DeeQay/KEDRA-KILIC-Diplomarbeit/docs/Diplomarbeit_Praesentation.pdf

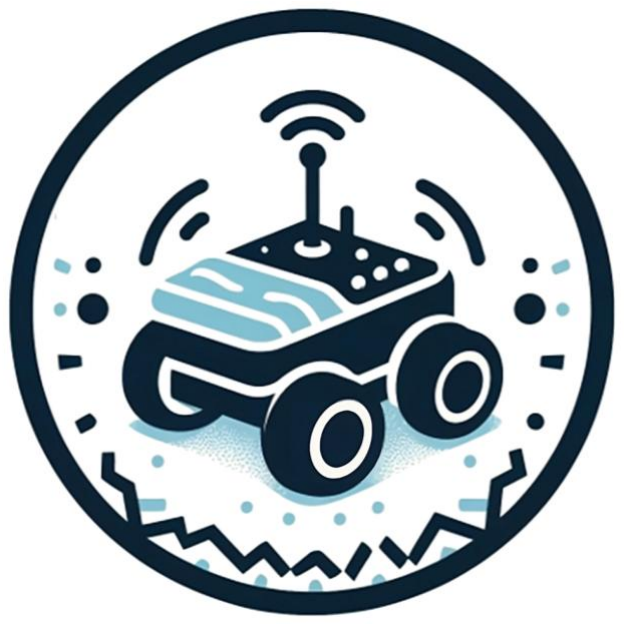
[picture p55: figure]

# Ferngesteuertes Fahrzeug mit Positionserkennung

Übungsteilnehmer: David KEDRA (verantwortlich), Berdan KILIC

2023/2024 5AHEL

Hauptbetreuer: Ahmet KILIC

Zusatzbetreuer: Heinrich HAAGER | 1 von 14

## David Kedra

Vorstellung

## - Ferngesteuertes Fahrzeug über Bluetooth - Umgebungserkennung und -speicherung - Bildschirm für Umgebung und Menü - Optimale Routenfindung zum markierten Punkt

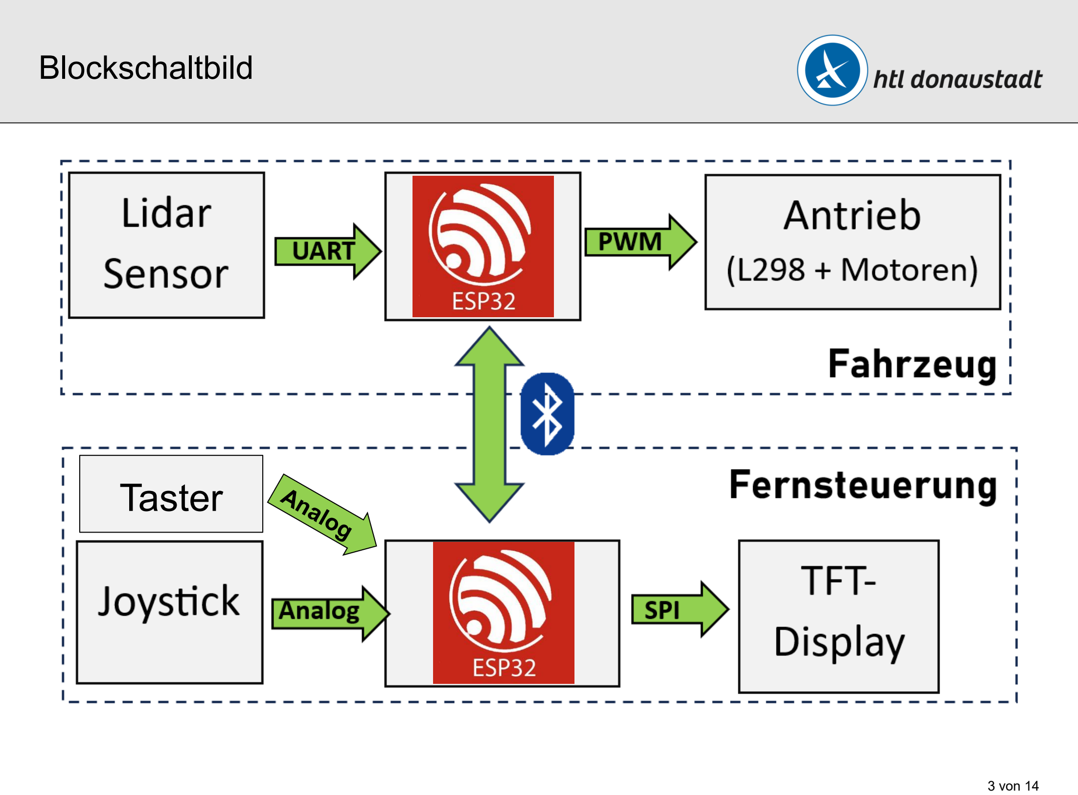
[picture p56: page 3]

Blockschaltbild

Taster

Aufgabenbereich der einzelnen Teilnehmer

## Berdan KILIC:

- Fahrzeugsteuerung

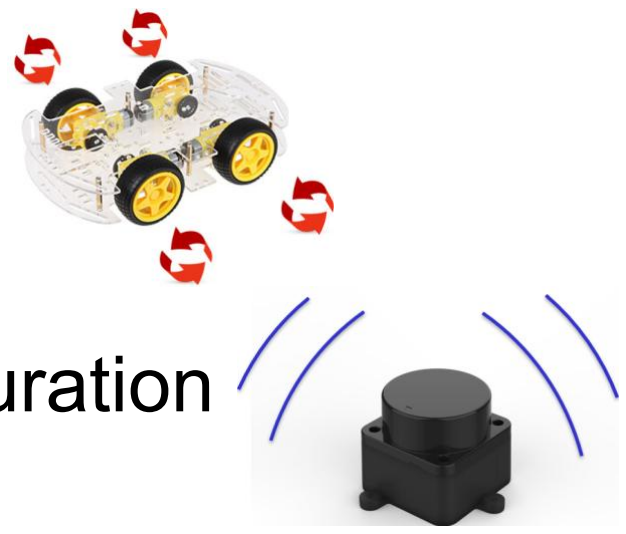
[picture p57: figure]

- 360° Sensor Konfiguration

## David KEDRA:

- Kommunikation der beiden Projektkomponenten

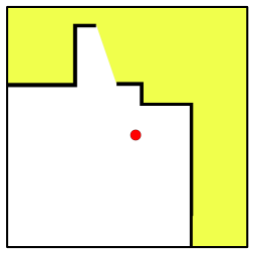
[picture p58: figure]

- Visualisierung am Bildschirm
- Umgebungsspeicherung

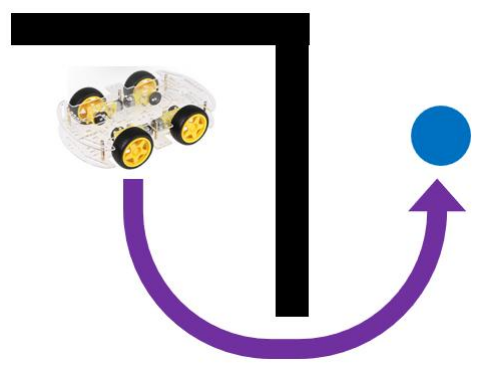
[picture p59: figure]

- Positionsrückfindung

Bluetooth - Kommunikation

## - Brücke zwischen Controller und Fahrzeug

## - drahtlose Datenübertragung

## - Bluetooth-Protokoll regelt Datenaustausch

Lidar

Joystick

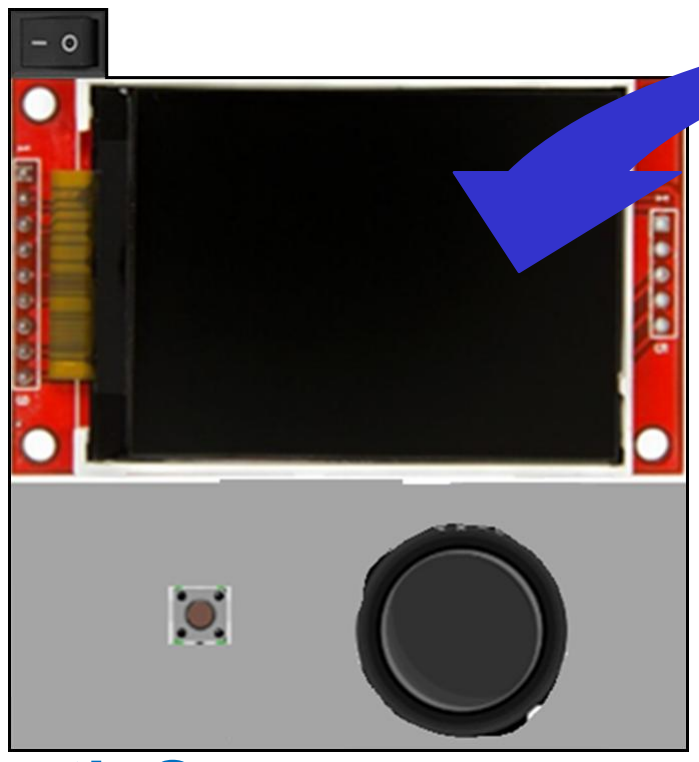
[picture p60: figure]
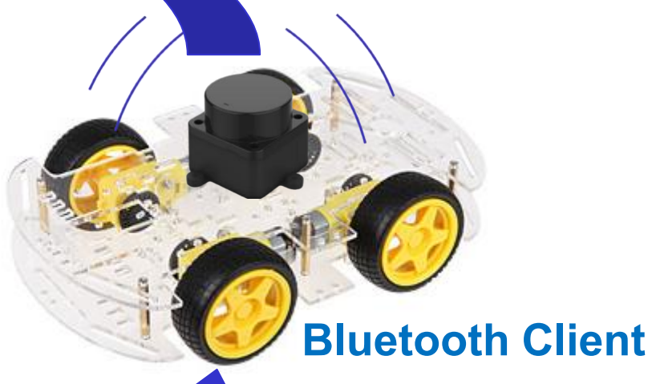
[picture p61: figure]
Bluetooth Client

Bluetooth Server

Bluetooth Datenformatierung

- Erste Information: Nachrichtentyp-Nummer
- Rest: übermittelte Daten

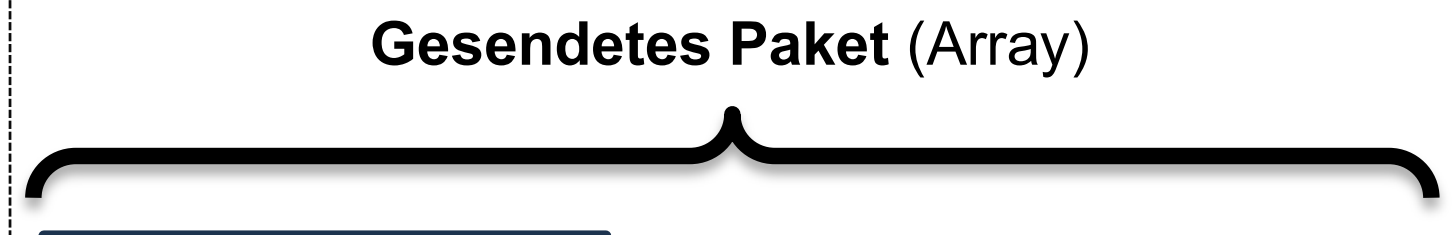
[picture p62: figure]
Gesendetes Paket (Array)
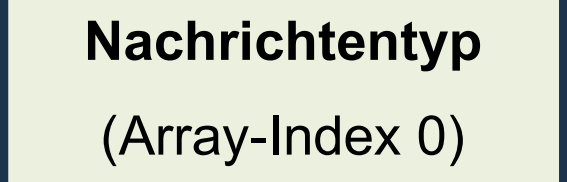
[picture p63: figure]
(Array-Index 0)

- Nachrichtentypen:
0 → Joystick
1 → Lidar
- Befehlszeichen:

\n → Nächster Wert einer Nachricht

\0 → Ende einer Nachricht Nachrichtentyp

Bluetooth Identifizierung der Formatierung

Joystick

Was gesendet wird: 0, \n, 5, 7, \n, 1, 4, 3, \0

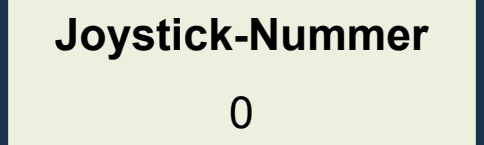
[picture p64: figure]
Joystick-Nummer
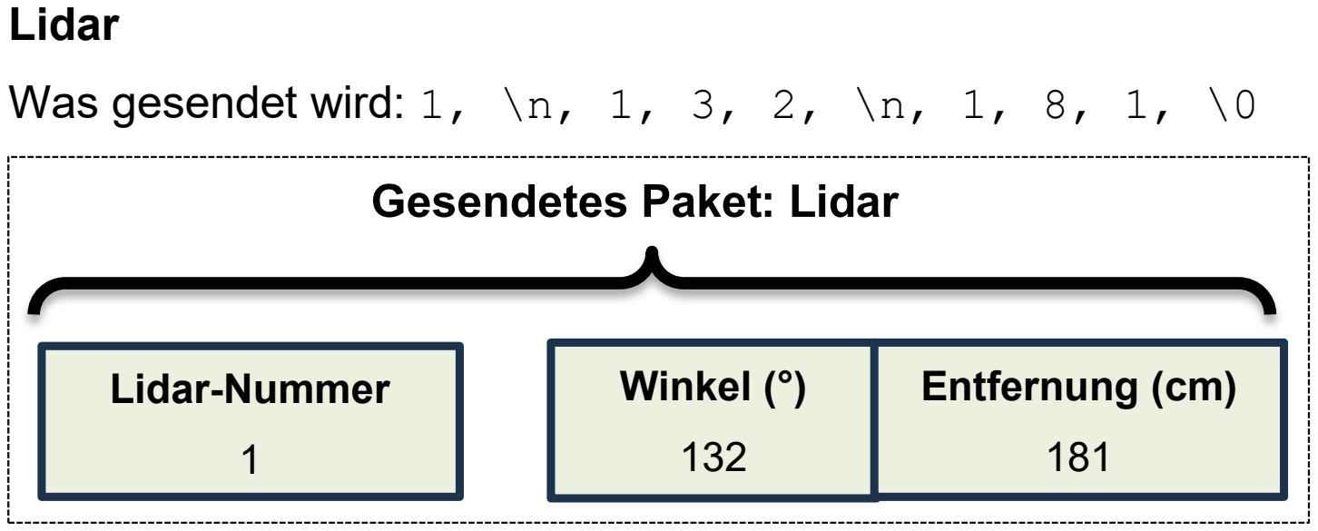
[picture p65: figure]
Lidar; Lidar-Nummer; Winkel (°); Gesendetes Paket: Lidar; Entfernung (cm)

Was gesendet wird: 1, \n, 1, 3, 2, \n, 1, 8, 1, \0

TFT-Display

## - TFT LCD Modul

## - 3,5 Zoll

## - 480x320 Pixel

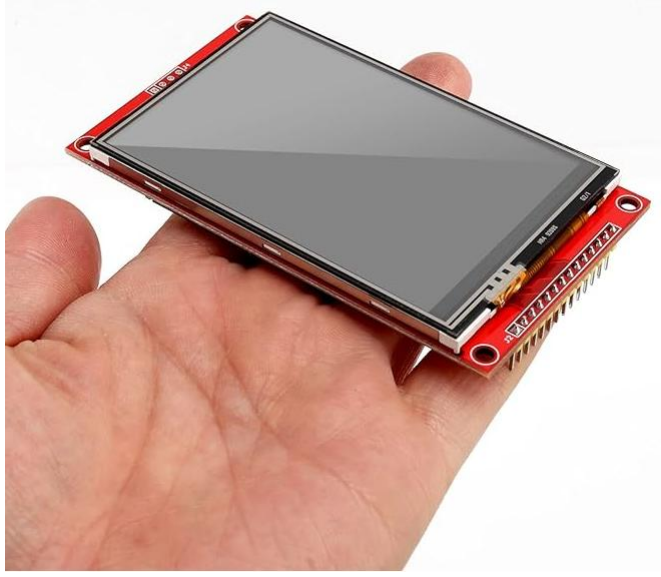
[picture p66: figure]

## - 4-Draht-SPI-Schnittstelle

## - ILI9488 Treiber

## - Information von 360° Sensor verarbeitet

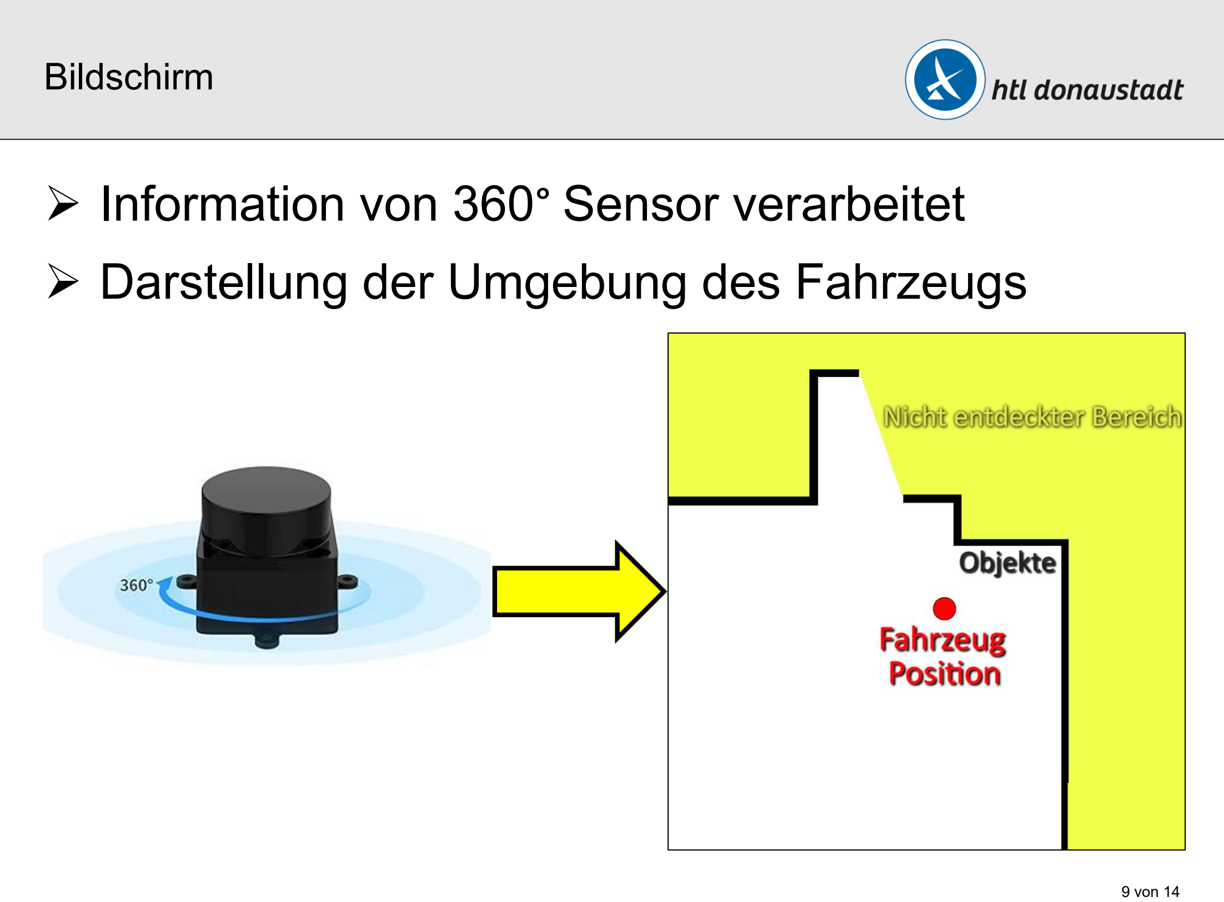
[picture p67: page 9]

Bildschirm

## - Darstellung der Umgebung des Fahrzeugs

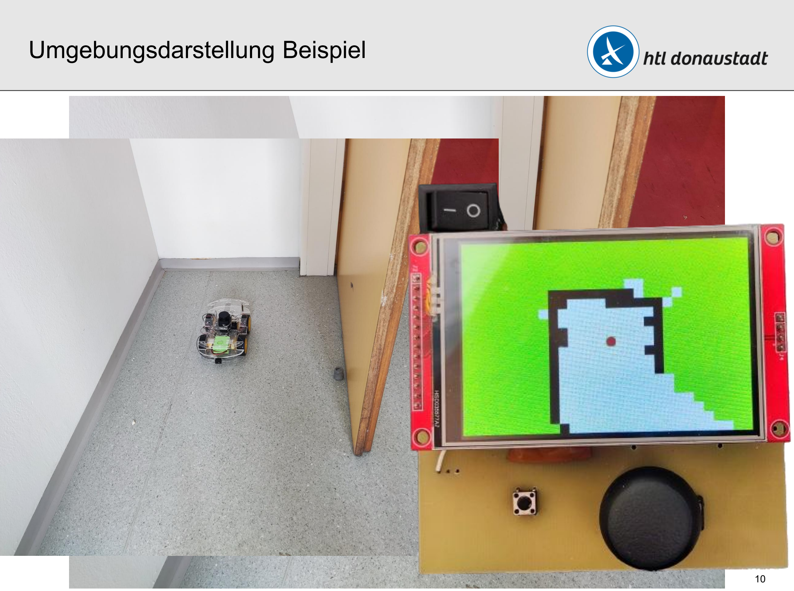
[picture p68: page 10]

Umgebungsdarstellung Beispiel

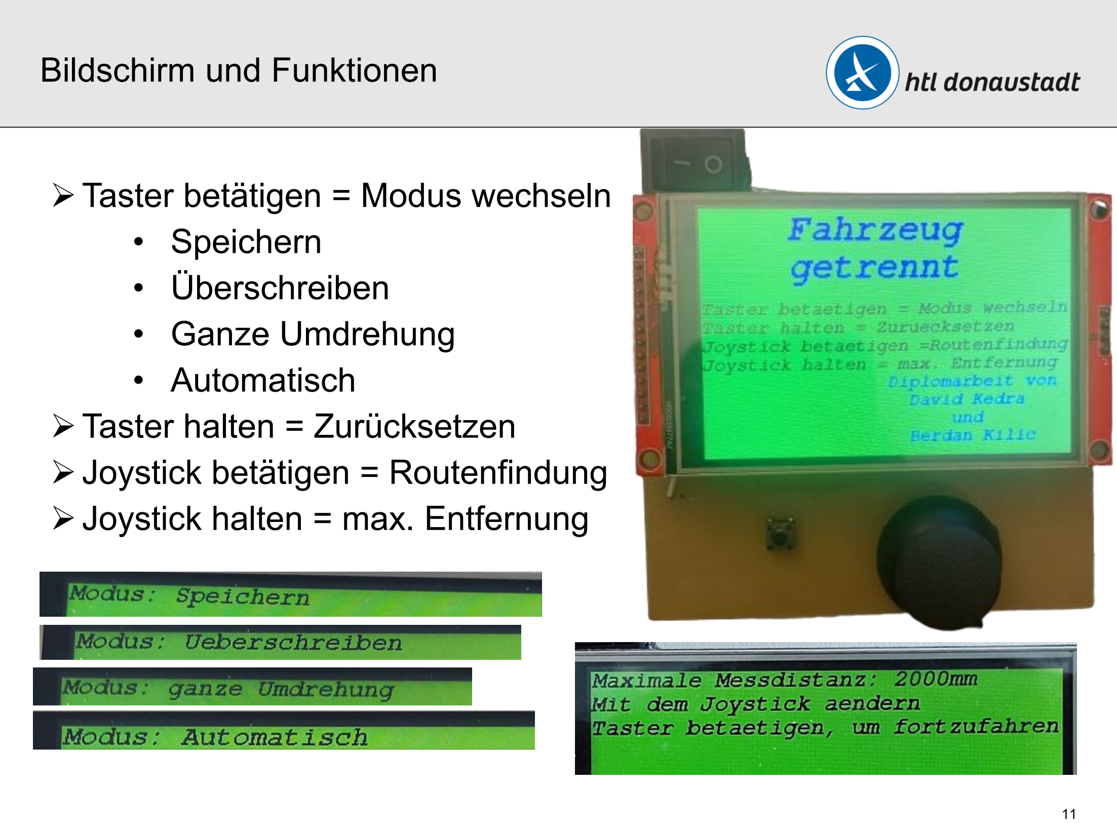
[picture p69: page 11]

Bildschirm und Funktionen

➢Taster betätigen = Modus wechseln
- Speichern
- Überschreiben
- Ganze Umdrehung
- Automatisch
➢Taster halten = Zurücksetzen ➢Joystick betätigen = Routenfindung ➢Joystick halten = max. Entfernung

Speichern und Überschreiben

1. Unbekannt zwischen Objekt und Anzeigeende (nur Überschreiben)
2. Luft zwischen Objekt und Lidar-Sensor aktualisieren

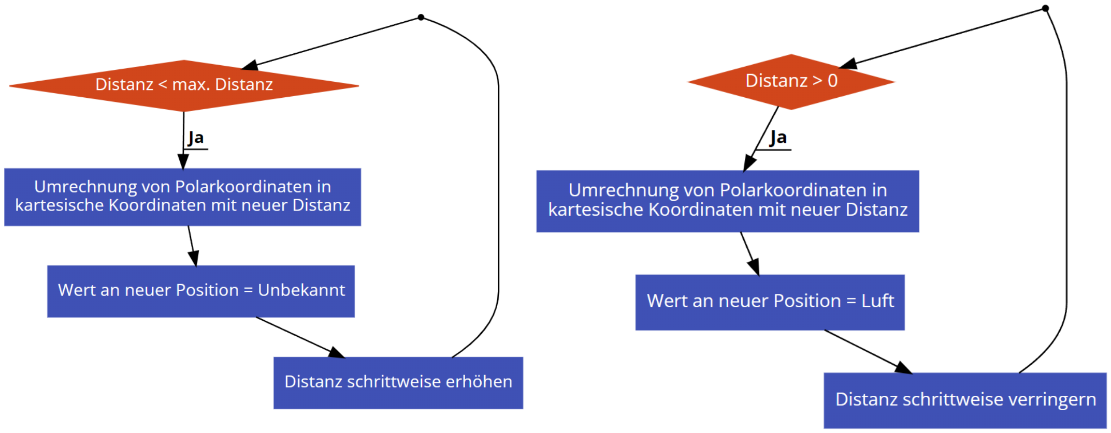
[picture p70: figure]
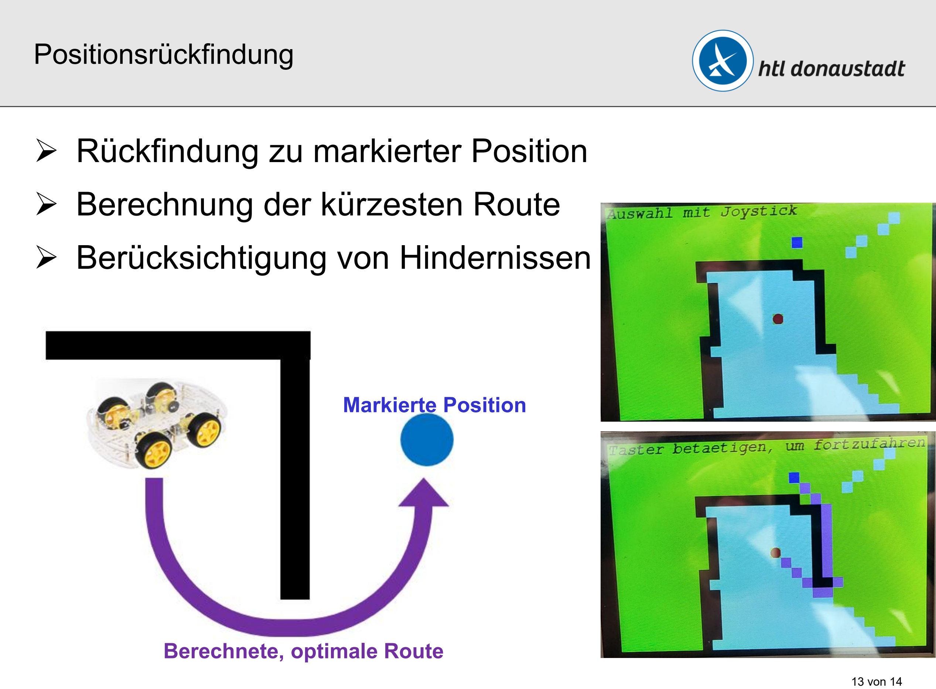
[picture p71: page 13]

Positionsrückfindung

- Rückfindung zu markierter Position
- Berechnung der kürzesten Route
- Berücksichtigung von Hindernissen

Berechnete, optimale Route

Markierte Position

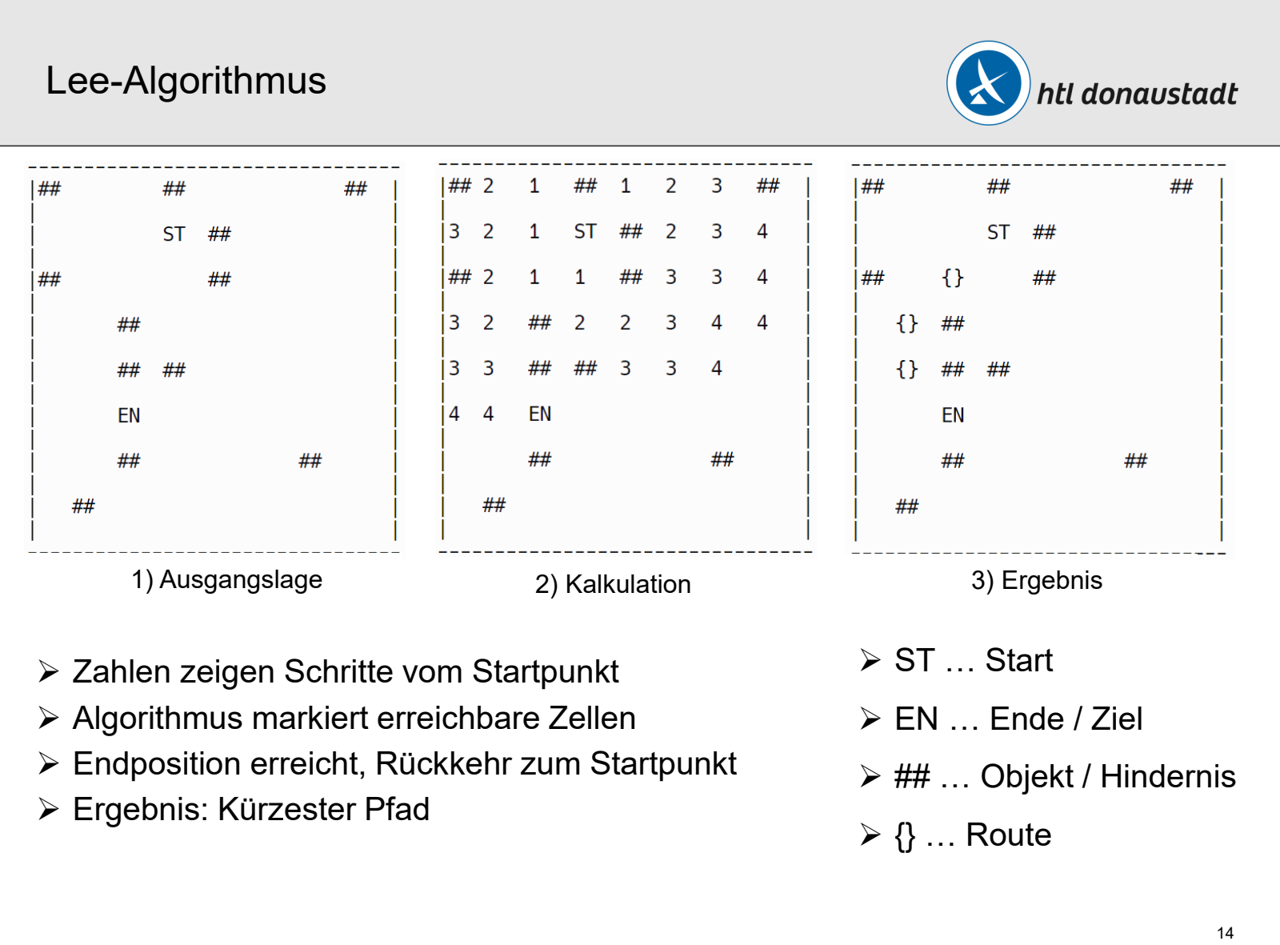
[picture p72: page 14]

Lee-Algorithmus

1) Ausgangslage | 2) Kalkulation | 3) Ergebnis
- ST … Start
- EN … Ende / Ziel
- ## … Objekt / Hindernis
- {} … Route
- Zahlen zeigen Schritte vom Startpunkt
- Algorithmus markiert erreichbare Zellen
- Endposition erreicht, Rückkehr zum Startpunkt
- Ergebnis: Kürzester Pfad

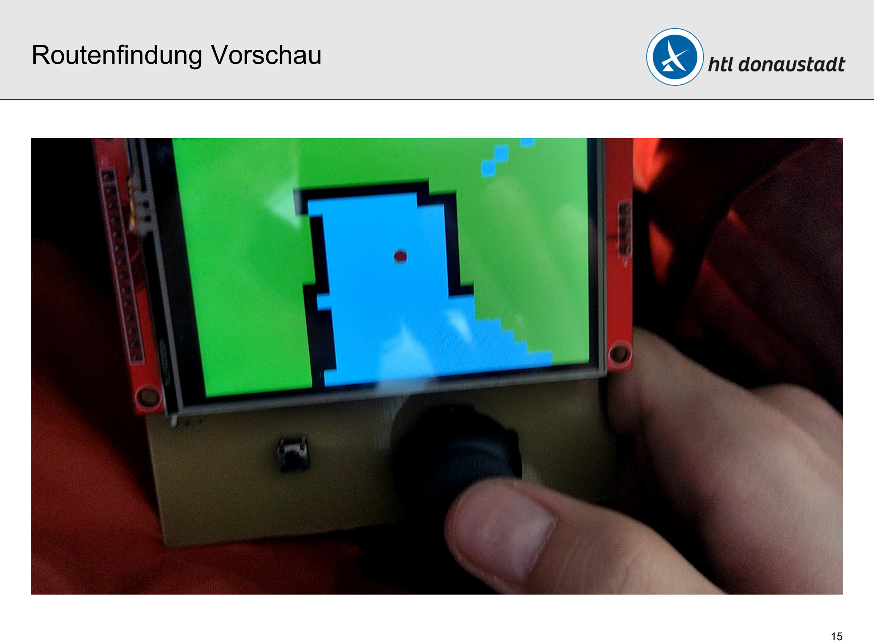
[picture p73: page 15]

Routenfindung Vorschau

Stromlaufplan

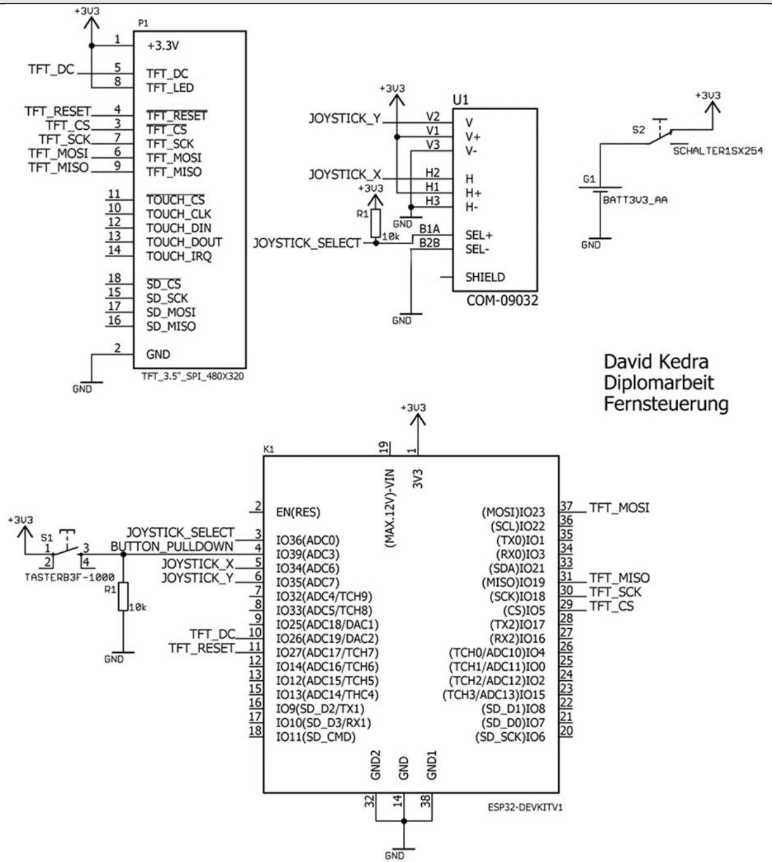
[picture p74: figure]
