DeeQay/KEDRA-KILIC-Diplomarbeit/docs/Projektvorstellung_2023-10.pdf

05.10.2023

## Ferngesteuertes Fahrzeug mit

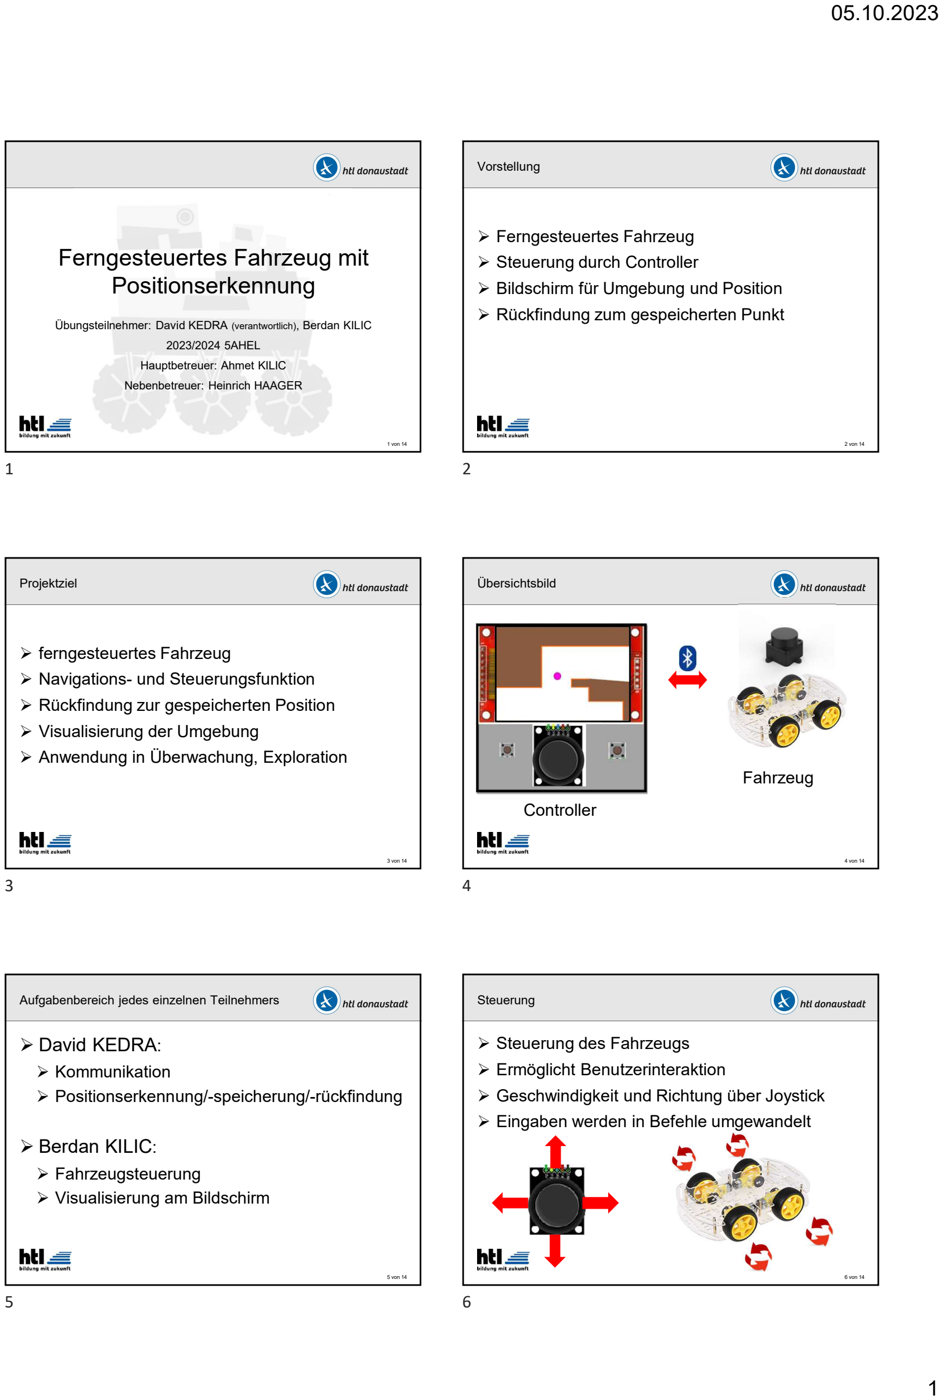
[picture p75: page 1]

1

## Positionserkennung

Übungsteilnehmer: David KEDRA (verantwortlich), Berdan KILIC 2023/2024 5AHEL
Hauptbetreuer: Ahmet KILIC Nebenbetreuer: Heinrich HAAGER

### 1 von 14

Vorstellung

- Ferngesteuertes Fahrzeug
- Steuerung durch Controller
- Bildschirm für Umgebung und Position
- Rückfindung zum gespeicherten Punkt | 2 von 14 Projektziel
- ferngesteuertes Fahrzeug
- Navigations- und Steuerungsfunktion
- Rückfindung zur gespeicherten Position
- Visualisierung der Umgebung
- Anwendung in Überwachung, Exploration

### 3 von 14

Übersichtsbild

Fahrzeug

Controller | 4 von 14 Aufgabenbereich jedes einzelnen Teilnehmers
- David KEDRA:
- Kommunikation
- Positionserkennung/-speicherung/-rückfindung
- Berdan KILIC:
- Fahrzeugsteuerung
- Visualisierung am Bildschirm

### 5 von 14

Steuerung

- Steuerung des Fahrzeugs
- Ermöglicht Benutzerinteraktion
- Geschwindigkeit und Richtung über Joystick
- Eingaben werden in Befehle umgewandelt 6 von 14

1 2

3 4

5 6

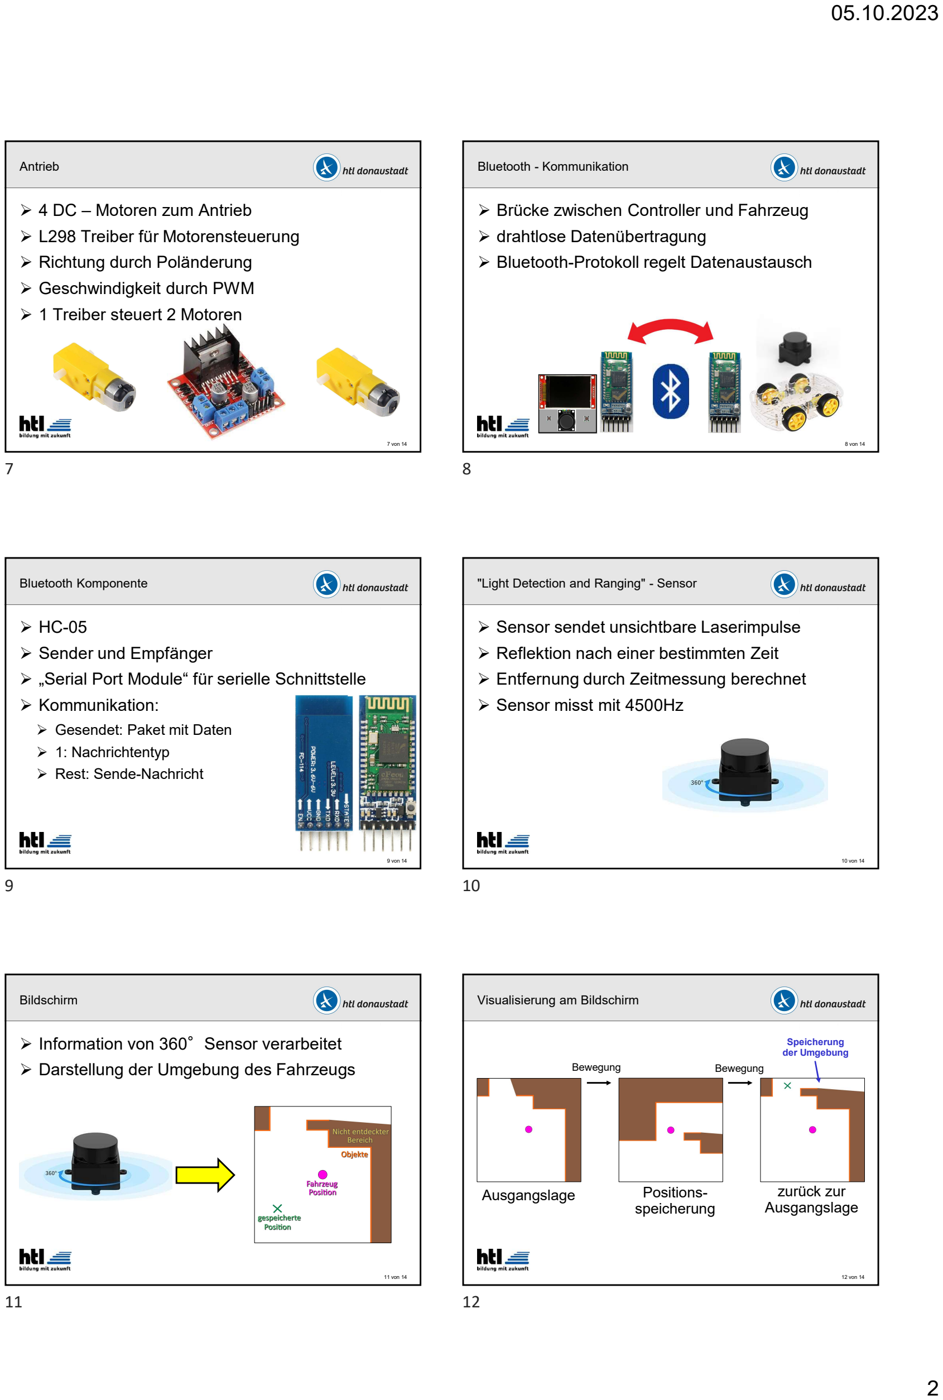
[picture p76: page 2]

2

Antrieb

- 4 DC – Motoren zum Antrieb
- L298 Treiber für Motorensteuerung
- Richtung durch Poländerung
- Geschwindigkeit durch PWM
- 1 Treiber steuert 2 Motoren

### 7 von 14

Bluetooth - Kommunikation

- Brücke zwischen Controller und Fahrzeug
- drahtlose Datenübertragung
- Bluetooth-Protokoll regelt Datenaustausch

### 8 von 14 Bluetooth Komponente

- HC-05
- Sender und Empfänger
- „Serial Port Module“ für serielle Schnittstelle
- Kommunikation:
- Gesendet: Paket mit Daten
- 1: Nachrichtentyp
- Rest: Sende-Nachricht | 9 von 14

"Light Detection and Ranging" - Sensor

- Sensor sendet unsichtbare Laserimpulse
- Reflektion nach einer bestimmten Zeit
- Entfernung durch Zeitmessung berechnet
- Sensor misst mit 4500Hz | 10 von 14 Bildschirm
- Information von 360°Sensor verarbeitet
- Darstellung der Umgebung des Fahrzeugs 11 von 14

Visualisierung am Bildschirm

Positionsspeicherung Ausgangslage

Bewegung | Bewegung

zurück zur
Ausgangslage

Speicherung
der Umgebung

### 12 von 14

7 8

9 10

11 12

3

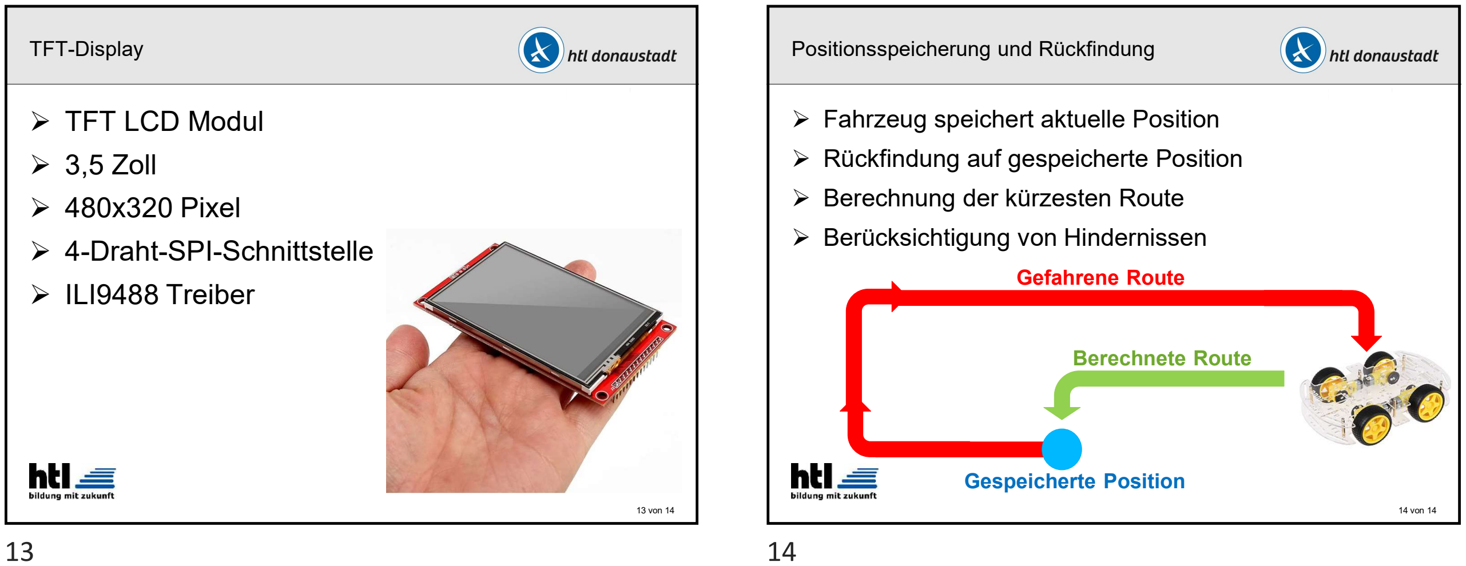
[picture p77: figure]
TFT-Display; TFT LCD Modul 3,5 Zoll 480x320 Pixel 4-Draht-SPI-Schnittstelle; ILI9488 Treiber; 13 von 14; Positionsspeicherung und Rückfindung; Fahrzeug speichert aktuelle Position Rückfindung auf gespeicherte Position Berechnung der kürzesten Route Berücksichtigung von Hindernissen; Gefahrene Route; Gespeicherte Position; Berechnete Route; 14 von 14
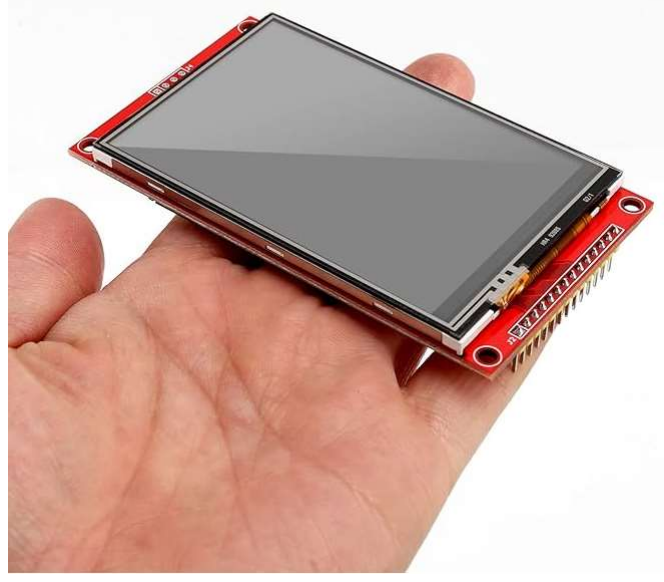
[picture p78: figure]
