DeeQay/KEDRA-KILIC-Diplomarbeit/Platinen/Fahrzeug/Fahrzeug.brd

## EAGLE design Platinen/Fahrzeug/Fahrzeug.brd (2024-04-22)

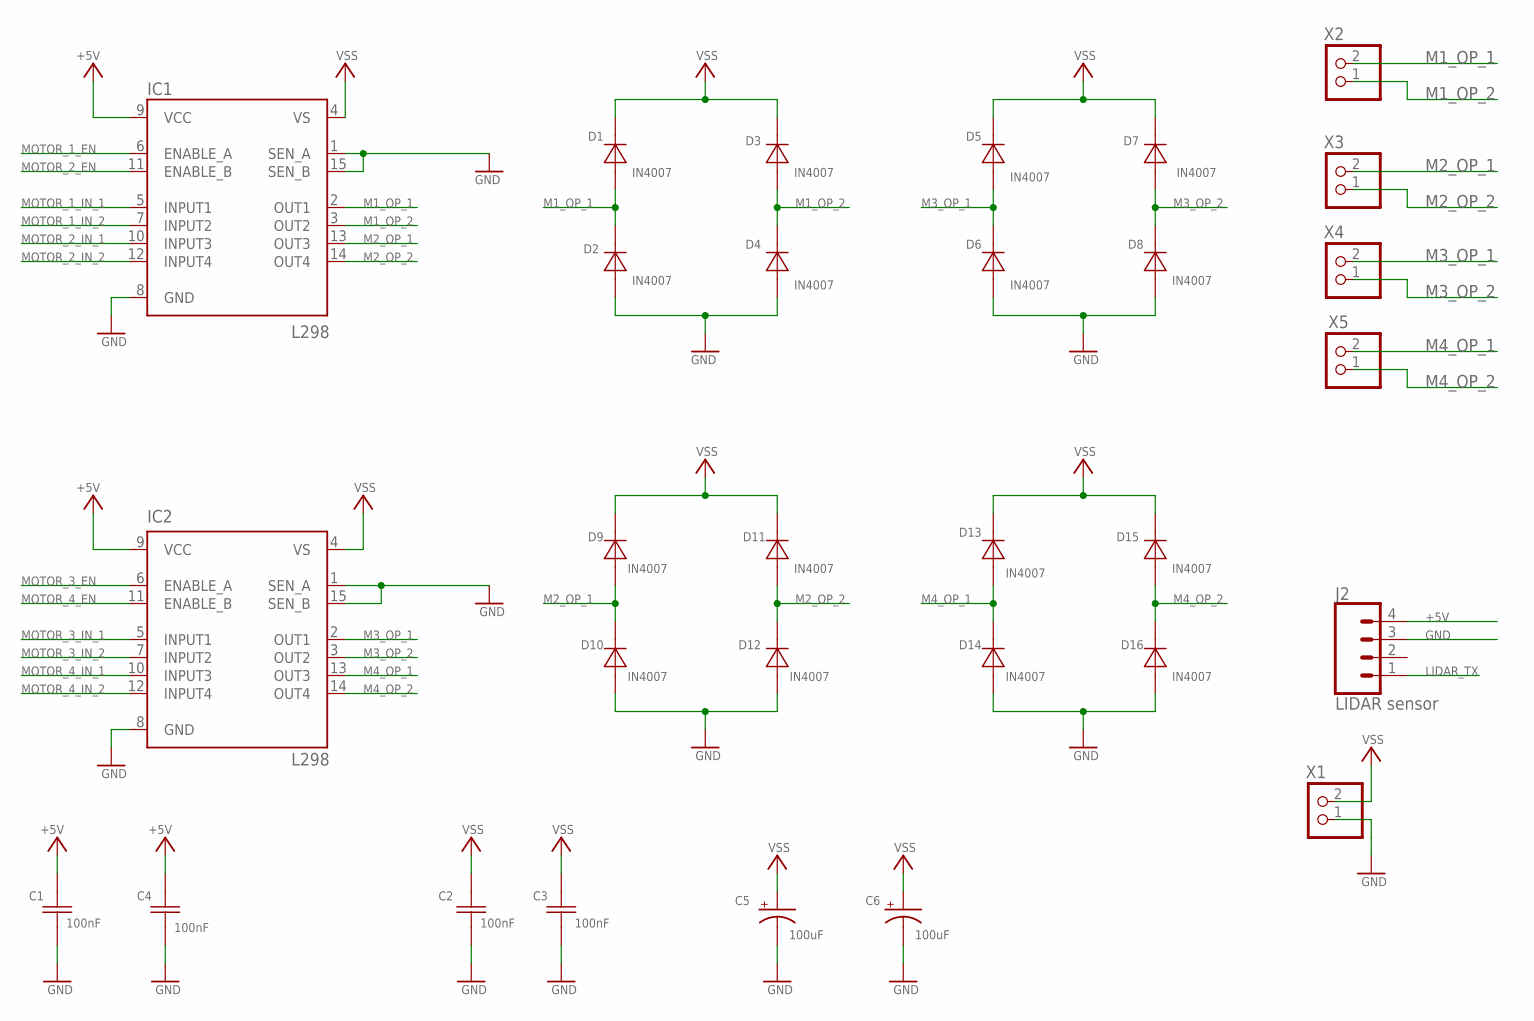
[picture p79: schematic Fahrzeug.sch, sheet 1]

Parts:
C1, C2, C3, C4: 100nF; R1206
C5, C6: 100uF; CPOL-RADIAL-2.5MM-6.5MM
D1, D2, D3, D4, D5, D6, D7, D8, D9, D10, D11, D12, D13, D14, D15, D16: IN4007; DO214AC
IC1, IC2: L298; MULTIWATT-15
J2: LIDAR sensor; MOLEX-1X4
X1, X2, X3, X4, X5: PINHD-1X2; 1X02

Connections:
+5V: C1.2, C4.2, IC1.9 (VCC), IC2.9 (VCC), J2.4; also elsewhere on the board
GND: C1.1, C2.1, C3.1, C4.1, C5.2 (-), C6.2 (-), D2.A, D4.A, D6.A, D8.A, D10.A, D12.A, D14.A, D16.A, IC1.1 (SEN_A), IC1.8 (GND), IC1.15 (SEN_B), IC2.1 (SEN_A), IC2.8 (GND), IC2.15 (SEN_B), J2.3, X1.1; also elsewhere on the board
LIDAR_TX: J2.1; also elsewhere on the board
M1_OP_1: D1.A, D2.C, IC1.2 (OUT1), X2.2
M1_OP_2: D3.A, D4.C, IC1.3 (OUT2), X2.1
M2_OP_1: D9.A, D10.C, IC1.13 (OUT3), X3.2
M2_OP_2: D11.A, D12.C, IC1.14 (OUT4), X3.1
M3_OP_1: D5.A, D6.C, IC2.2 (OUT1), X4.2
M3_OP_2: D7.A, D8.C, IC2.3 (OUT2), X4.1
M4_OP_1: D13.A, D14.C, IC2.13 (OUT3), X5.2
M4_OP_2: D15.A, D16.C, IC2.14 (OUT4), X5.1
MOTOR_1_EN: IC1.6 (ENABLE_A); also elsewhere on the board
MOTOR_1_IN_1: IC1.5 (INPUT1); also elsewhere on the board
MOTOR_1_IN_2: IC1.7 (INPUT2); also elsewhere on the board
MOTOR_2_EN: IC1.11 (ENABLE_B); also elsewhere on the board
MOTOR_2_IN_1: IC1.10 (INPUT3); also elsewhere on the board
MOTOR_2_IN_2: IC1.12 (INPUT4); also elsewhere on the board
MOTOR_3_EN: IC2.6 (ENABLE_A); also elsewhere on the board
MOTOR_3_IN_1: IC2.5 (INPUT1); also elsewhere on the board
MOTOR_3_IN_2: IC2.7 (INPUT2); also elsewhere on the board
MOTOR_4_EN: IC2.11 (ENABLE_B); also elsewhere on the board
MOTOR_4_IN_1: IC2.10 (INPUT3); also elsewhere on the board
MOTOR_4_IN_2: IC2.12 (INPUT4); also elsewhere on the board
VSS: C2.2, C3.2, C5.1 (+), C6.1 (+), D1.C, D3.C, D5.C, D7.C, D9.C, D11.C, D13.C, D15.C, IC1.4 (VS), IC2.4 (VS), X1.2; also elsewhere on the board

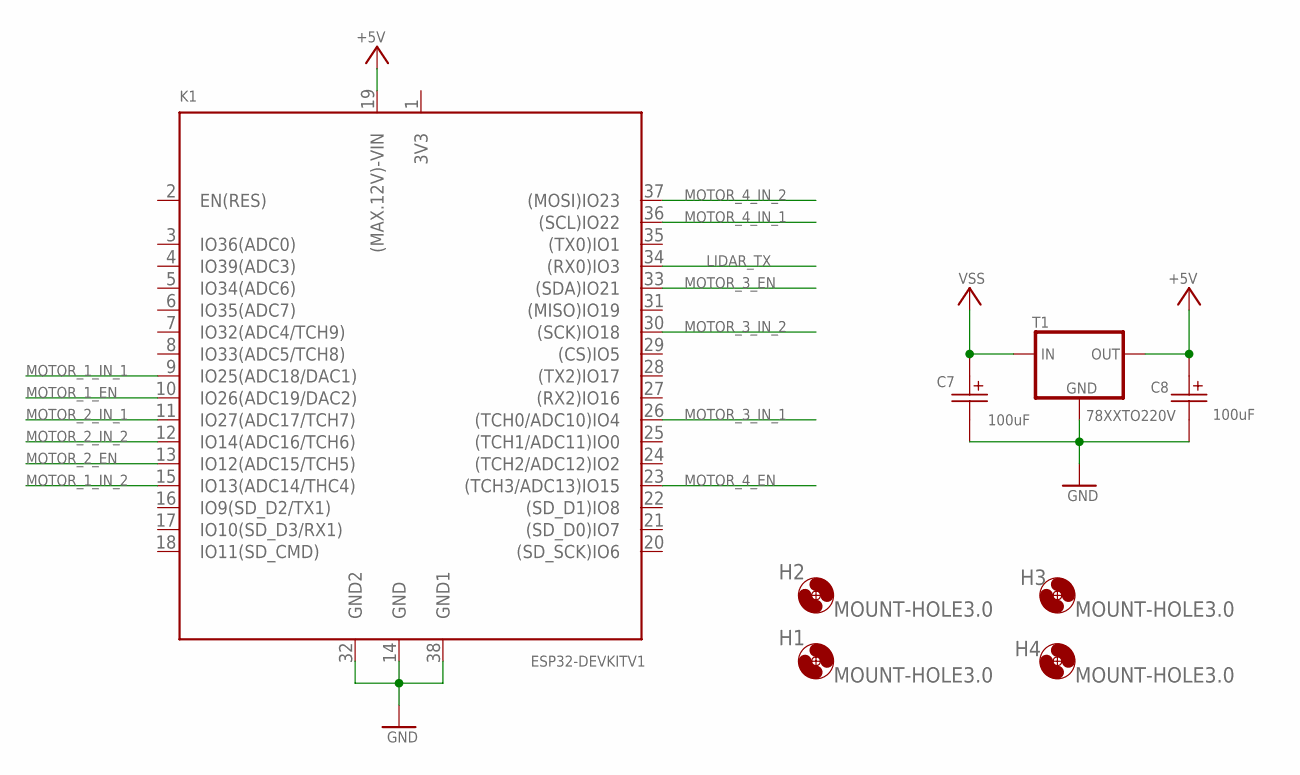
[picture p80: schematic Fahrzeug.sch, sheet 2]

Parts:
C7, C8: 100uF; E2,5-5
H1, H2, H3, H4: MOUNT-HOLE3.0; 3,0
K1: ESP32DEVKITV11000MIL; ESP32-DEVKITV1
T1: 78XXTO220V; 78-TO220V

Connections:
+5V: C8.+, K1.19 ((MAX.12V)-VIN), T1.OUT; also elsewhere on the board
GND: C7.-, C8.-, K1.14 (GND), K1.32 (GND2), K1.38 (GND1), T1.GND; also elsewhere on the board
LIDAR_TX: K1.34 ((RX0)IO3); also elsewhere on the board
MOTOR_1_EN: K1.10 (IO26(ADC19/DAC2)); also elsewhere on the board
MOTOR_1_IN_1: K1.9 (IO25(ADC18/DAC1)); also elsewhere on the board
MOTOR_1_IN_2: K1.15 (IO13(ADC14/THC4)); also elsewhere on the board
MOTOR_2_EN: K1.13 (IO12(ADC15/TCH5)); also elsewhere on the board
MOTOR_2_IN_1: K1.11 (IO27(ADC17/TCH7)); also elsewhere on the board
MOTOR_2_IN_2: K1.12 (IO14(ADC16/TCH6)); also elsewhere on the board
MOTOR_3_EN: K1.33 ((SDA)IO21); also elsewhere on the board
MOTOR_3_IN_1: K1.26 ((TCH0/ADC10)IO4); also elsewhere on the board
MOTOR_3_IN_2: K1.30 ((SCK)IO18); also elsewhere on the board
MOTOR_4_EN: K1.23 ((TCH3/ADC13)IO15); also elsewhere on the board
MOTOR_4_IN_1: K1.36 ((SCL)IO22); also elsewhere on the board
MOTOR_4_IN_2: K1.37 ((MOSI)IO23); also elsewhere on the board
VSS: C7.+, T1.IN; also elsewhere on the board

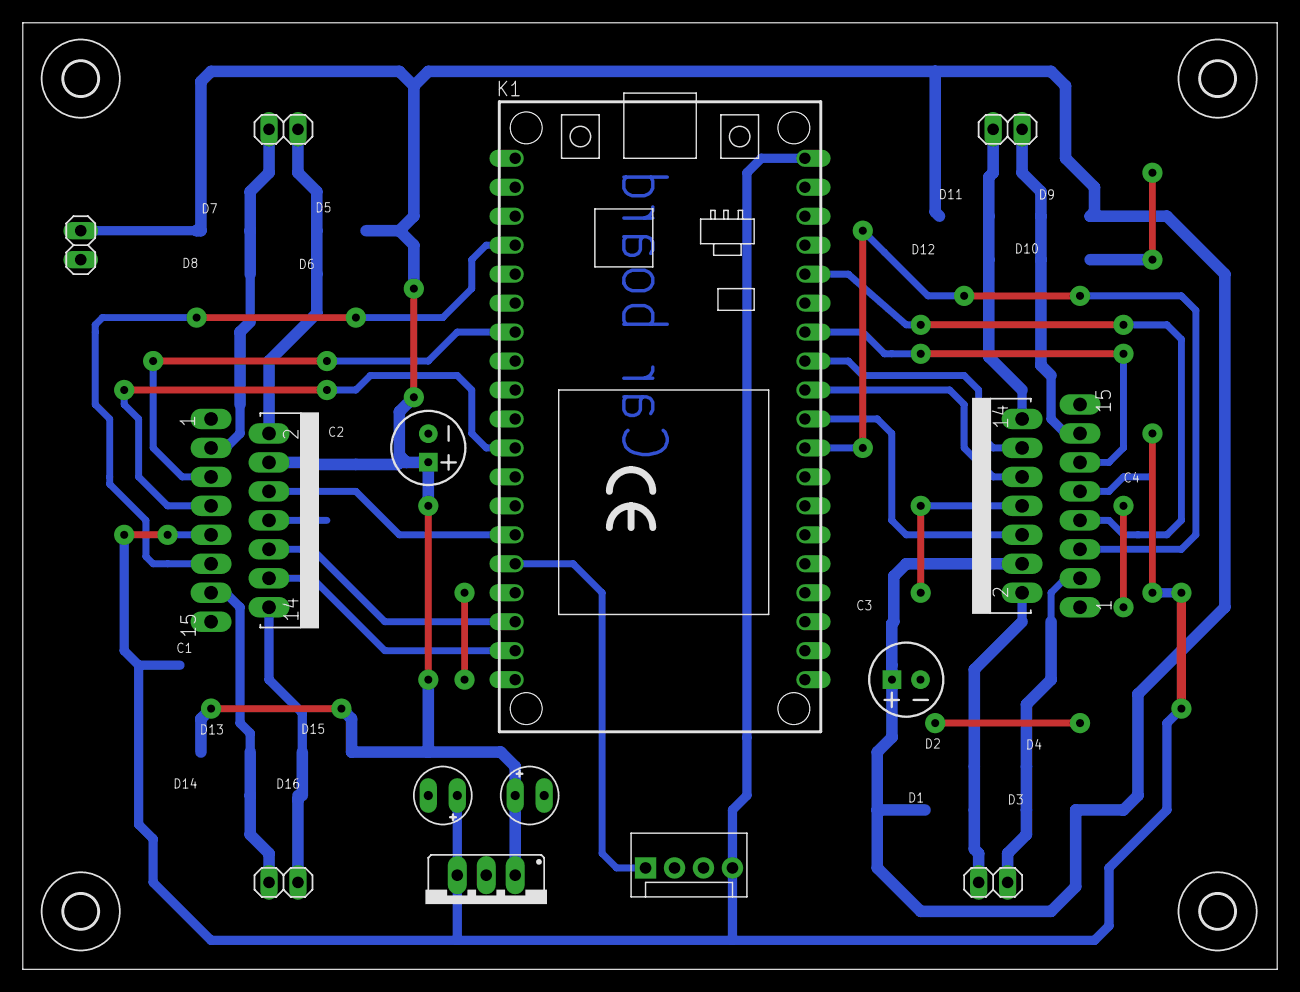
[picture p81: board Fahrzeug.brd from above]

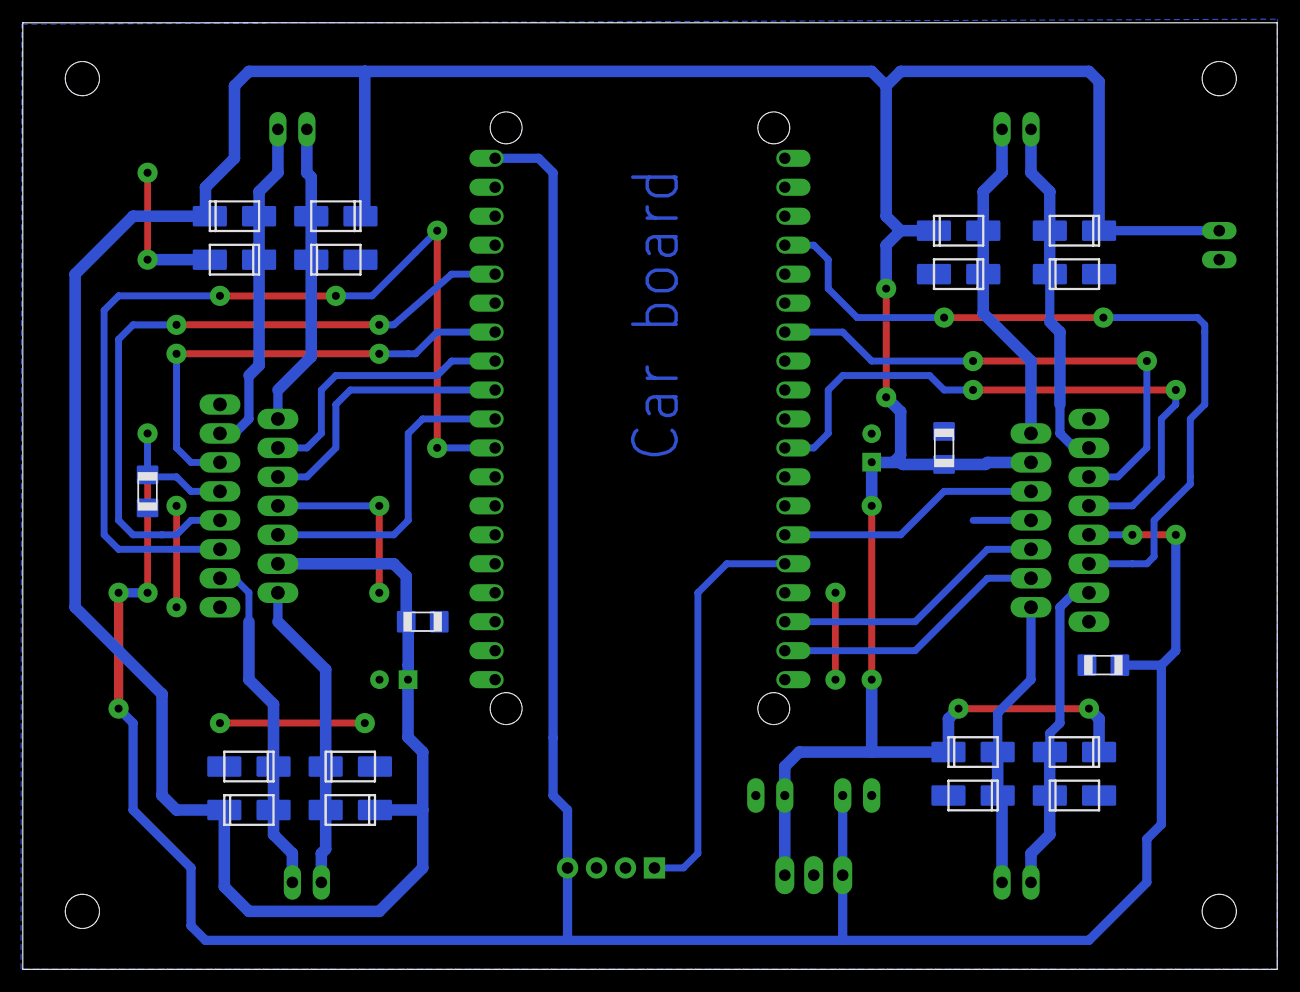
[picture p82: board Fahrzeug.brd from below]

Board: 2 copper layers, 110.0 x 83.0 mm, 43 parts (20 on the bottom side), 24 nets.

Other parts of the board:
DRILEGEND: DRILEGEND
U$3, U$4: ARROW-->
U$5, U$6: ARROW<--
