DeeQay/KEDRA-KILIC-Diplomarbeit/Platinen/Fernsteuerung/Fernsteuerung.brd

## EAGLE design Platinen/Fernsteuerung/Fernsteuerung.brd (2024-04-22)

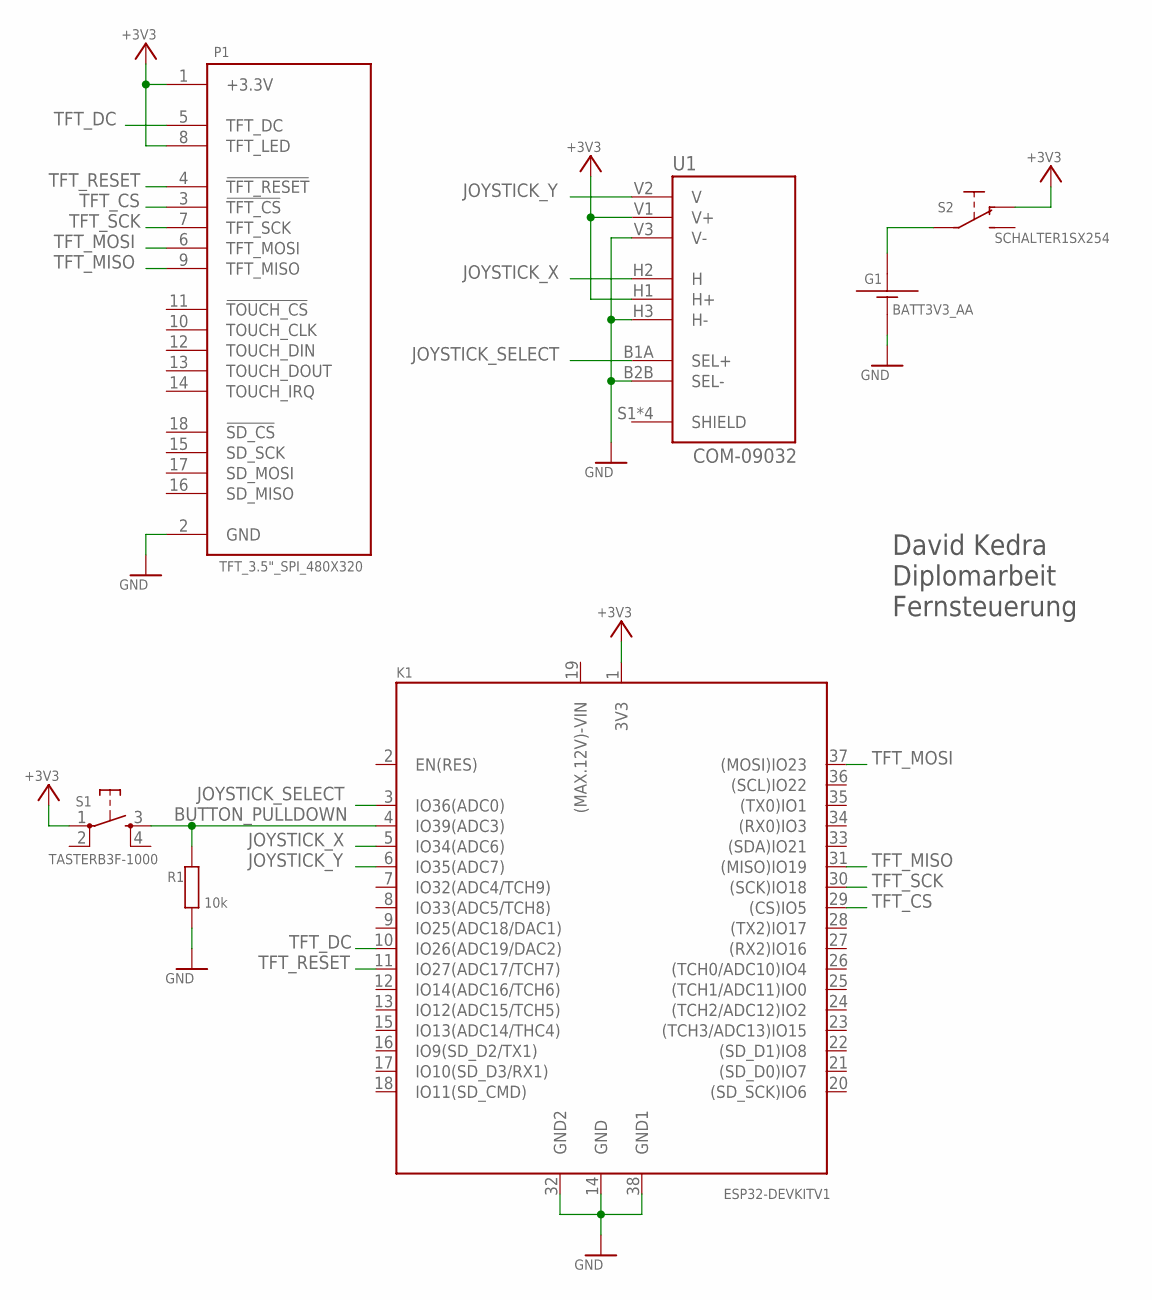
[picture p83: schematic Fernsteuerung.sch]

Parts:
G1: BATT3V3_AA; BATT-3V3-AA
K1: ESP32DEVKITV11000MIL; ESP32-DEVKITV1
P1: TFT_3.5"_SPI_480X320
R1: 10k; R1206
S1: TASTERB3F-1000; B3F-10XX
S2: SCHALTER1SX254; SX254
U1: COM-09032; XDCR_COM-09032

Connections:
+3V3: K1.1 (3V3), P1.1 (+3.3V), P1.8 (TFT_LED), S1.1, S2.O1, U1.H1 (H+), U1.V1 (V+)
BATTERY_+3V3: G1.PLUS, S2.W1
BUTTON_PULLDOWN: K1.4 (IO39(ADC3)), R1.2, S1.3 (S)
GND: G1.MINUS, K1.14 (GND), K1.32 (GND2), K1.38 (GND1), P1.2 (GND), R1.1, U1.B2B (SEL-), U1.H3 (H-), U1.V3 (V-)
JOYSTICK_SELECT: K1.3 (IO36(ADC0)), U1.B1A (SEL+)
JOYSTICK_X: K1.5 (IO34(ADC6)), U1.H2 (H)
JOYSTICK_Y: K1.6 (IO35(ADC7)), U1.V2 (V)
TFT_CS: K1.29 ((CS)IO5), P1.3 (!TFT_CS!)
TFT_DC: K1.10 (IO26(ADC19/DAC2)), P1.5 (TFT_DC)
TFT_MISO: K1.31 ((MISO)IO19), P1.9 (TFT_MISO)
TFT_MOSI: K1.37 ((MOSI)IO23), P1.6 (TFT_MOSI)
TFT_RESET: K1.11 (IO27(ADC17/TCH7)), P1.4 (!TFT_RESET!)
TFT_SCK: K1.30 ((SCK)IO18), P1.7 (TFT_SCK)

Notes on the sheet:
David Kedra Diplomarbeit Fernsteuerung

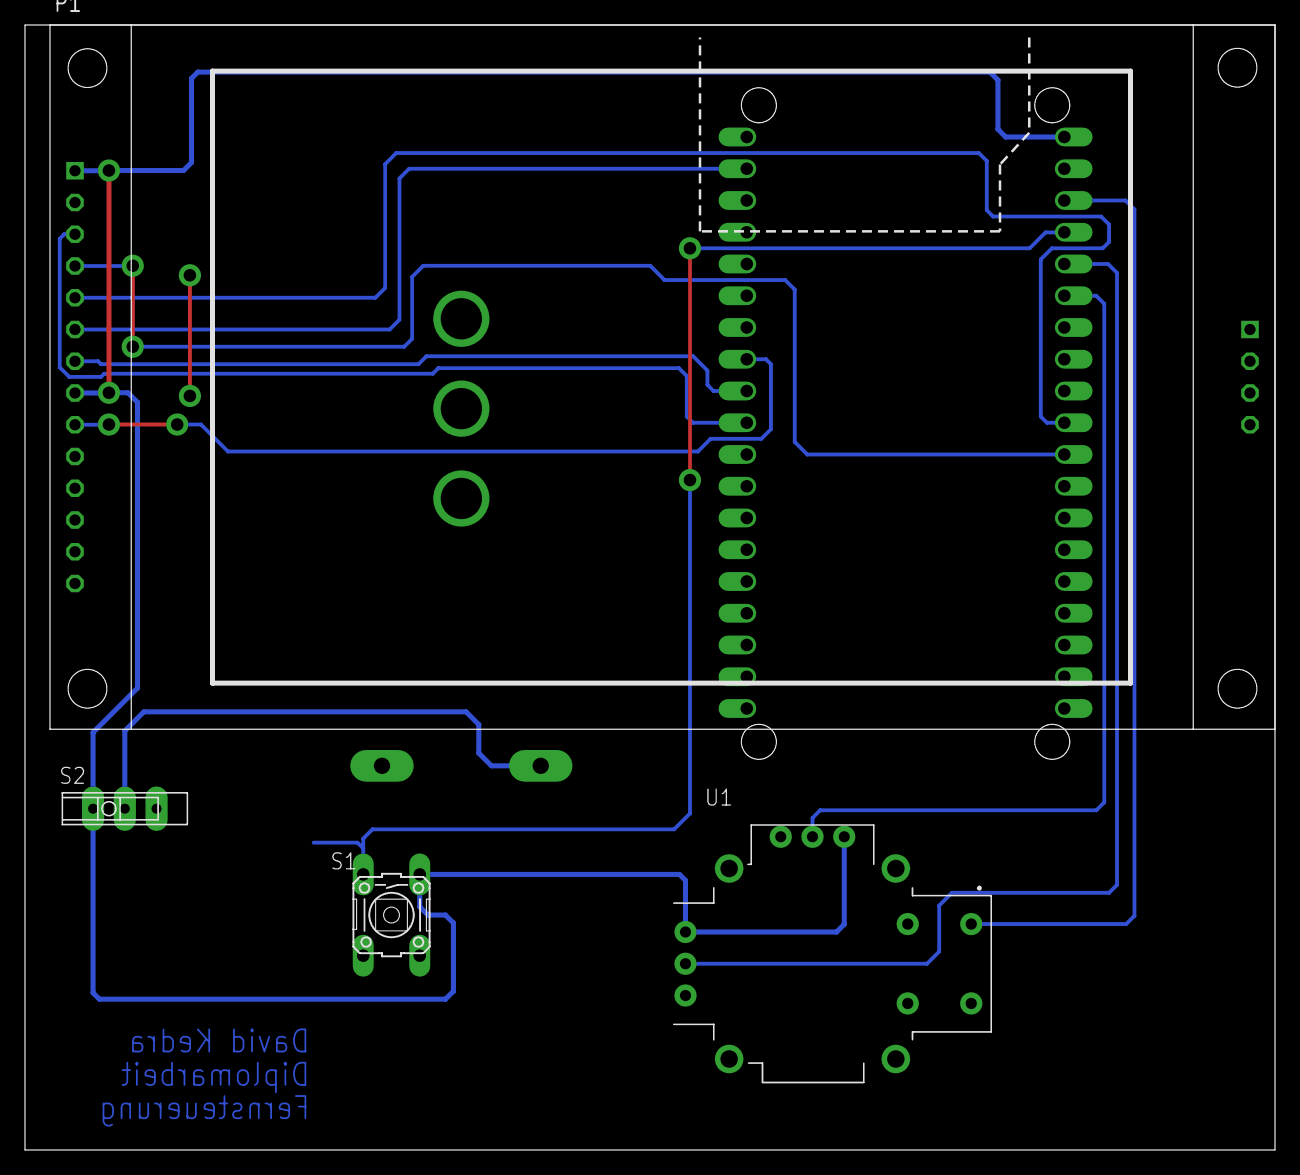
[picture p84: board Fernsteuerung.brd from above]

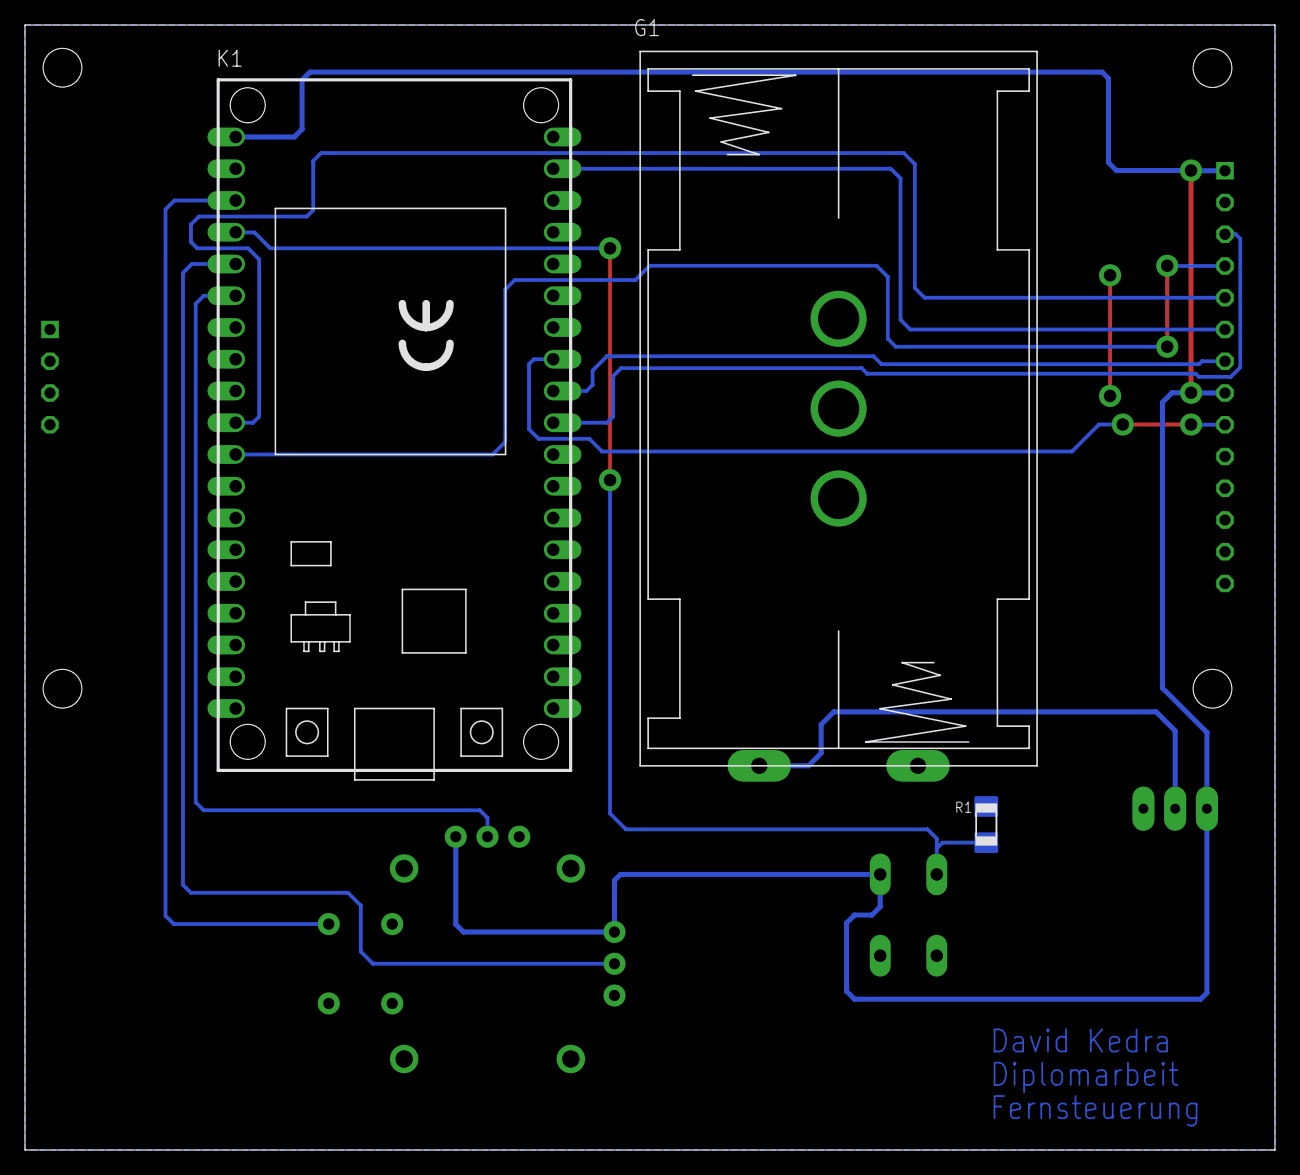
[picture p85: board Fernsteuerung.brd from below]

Board: 2 copper layers, 100.0 x 90.0 mm, 12 parts (3 on the bottom side), 13 nets.

Other parts of the board:
DRILEGEND: DRILEGEND
U$1, U$2: ARROW-->
U$3, U$4: ARROW<--
