DeeQay/KEDRA-KILIC-Diplomarbeit/Programmcode/Fernsteuerung/joystick.h

// Programmersteller: Berdan KILIC & David Kedra

#ifndef JOYSTICK_H
#define JOYSTICK_H

#include <Arduino.h>

class Joystick {
public:
  Joystick(int8_t xPin, int8_t yPin, int8_t selectPin);
  void init();
  int xAxis();
  int yAxis();
  bool pressed();
private:
  int8_t _xPin;
  int8_t _yPin;
  int8_t _selectPin;
};

#endif
