DeeQay/KEDRA-KILIC-Diplomarbeit/Programmcode/Fahrzeug/pins.h

// Motor driver 1 pins
#define driver_1_in1 25
#define driver_1_in2 13
#define driver_1_in3 27
#define driver_1_in4 14
// Motor driver 1 enable pins
#define driver_1_en1 26
#define driver_1_en2 12
// Motor driver 2 pins
#define driver_2_in1 4
#define driver_2_in2 18
#define driver_2_in3 22
#define driver_2_in4 23
// Motor driver 2 enable pins
#define driver_2_en1 21
#define driver_2_en2 15
