DeeQay/KEDRA-KILIC-Diplomarbeit/(commit log)

2023-09-09 Bluetooth Kommunikation Senden und Empfangen
    Erster upload der Klasse Bluetooth Kommunikation für zwei Arduino Geräte.
    Datum der Programmierung: 23-24.8.2023
2023-09-09 Arduino display
    test code für Arduino Display ili9488 driver
    Programming Datum: 2.9.2023
2023-09-11 SendMessage type change & connection status (nicht fertig)
    Bluetooth Nachrichtentyp geändert von string zu int.
    Beginn von Ping (nicht fertig): Überprüfung ob die Bluetooth Geräte miteinander verbunden sind.
2023-09-22 Bluetooth Klasse fertig
    baudrate erhöht auf 38400.
    Es wird jetzt ein character array gesendet.
    Controller und Fahrzeug code getrennt. Beide können Senden und Empfangen.
2023-09-29 Lidar start
    Lidar Pins und Datenblatt hinzugefügt
2023-09-29 Pin änderung + Kommentare hinzugefügt
    TX und RX Pins vertauscht.
    Kommentare und Konsolenausgaben in Deutsch.
    Mehrere Kommentare hinzugefügt.
2023-09-29 Eagle Stromlaufplan
    Bluetooth test Stromlaufplan hinzugefügt.
    [bt_test.sch]
2023-11-18 bluetooth angepasst auf esp32.
    bluetooth angepasst auf esp32.
    baudrate auf 115200 geändert.
    controller und auto code.
    getestet mit arduino und esp32. Funktioniert.
2024-01-12 Controller bluetooth und joystick update
    Zusammen aktualisiert mit "Car bluetooth und joystick update"
2024-01-13 Umgebungsspeicherung
    Geschrieben am 12.1 und 13.1.2024.
    Umgebung wird in einem 2D Vektor (wie ein 2D Array) gespeichert: `position`.
    Winkel `angle` und Entfernung `distance` wird verarbeitet zu x und y Koordinaten und im Array gespeichert.
    Die Auflösung des Speichers kann eingestellt werden.
2024-02-23 update bluetooth für zwei ESP32
    Zwei ESP32 mit buildin Bluetooth: ohne HC05.
    Verbindung funktioniert. Einbindung in bluetooth Klasse muss gemacht werden.
2024-03-08 update display code für esp32
2024-03-08 Bluetooth Verbindung 2x ESP32
    Änderung des Codes und Testung von Senden und Empangen von Daten zwischen zwei ESP32's.
    Testung erfolgreich.
    Problem: Delay erforderlich, da es sonst zu falschen Dateiübertragung kommt.
    Lösungsansatz/todo: Überprüfung der empfangenen Daten, in dem man zu jedem Paket zusätzliche Überprüfungs-Bits verschickt.
    [Bluetooth.cpp, carControl.cpp]
2024-03-15 Umgebungsspeicherung und dessen Anzeige auf ESP32
    Umgebungsspeicherung und dessen Anzeige erfolgreich auf ESP32 mit TFT-Display funktioniert.
2024-03-15 Umgebungsspeicherung und dessen Anzeige INFO!
    ACHTUNG: C:\Users\Lenovo\Documents\Arduino\libraries\ILI9486_SPI\src
    FILE: ILI9486_SPI.cpp
    Ändern #define SPI_SPEED auf 40MHz
2024-03-17 Umgebungsspeicherung um einiges optimiert.
    ganzen Tag gearbeitet um den code schneller zu machen.
    Notiz: Dieser Part
    ```Cpp
    pos.x = (xFloat * halfMaxPosX + 0.5) * MAX_POSITION_X;
    pos.y = (yFloat * halfMaxPosY + 0.5) * MAX_POSITION_Y;
    ```
    verbraucht am meisten Leistung/Zeit.
    In einem Test braucht der Test 170ms ohne dieser Berechnung und 1500ms mit dieser Berechnung.
2024-03-17 Dokumentation für die Optimierung der Umgebungsspeicherung erstellt
2024-03-21 Eagle Fernsteuerung + Display library
    Eagle library für das TFT SPI 3.5inch 480x320 Display mit dem Treiber ILI9488 erstellt.
    Schematic für die Fernsteuerung angefangen.
    [Fernsteuerung.sch]
2024-03-21 Update TFT SPI 3.5inch 480x320 ILI9488.lbr
2024-03-22 Freitag commit
    [Fernsteuerung.brd, Fernsteuerung.sch]
2024-03-23 Code anpassen für Empfangen/Senden der Werte für Lidar
2024-03-25 LidarMapper für die Umgebungsspeicherung fixen
    Hatte einen ERROR!
    Wurde gelöst und funktioniert wieder.
    TODO: Testzeit für die Dokumentation neu messen
    [LidarMapper.cpp]
2024-03-29 Aktuelle Codeversion
    Sensor integriert
2024-03-29 LidarMapper/TFT/pins Klassen + Object Lücken füllen
    Klassen für TFT und Pins erstellt.
    angle von float zu int geändert.
    TFT: Bei einer Lücke zwischen zwei OBJECT werden gefüllt mit einer Linie.
    [bt_test arduino nano + hc05.sch]
2024-03-31 `distance, angle` -> `angle, distance`
    Umgebungsspeicherung Parameter Reihenfolge anpassen, sodass es so wie im der Rest des Codes ist.
2024-04-02 BT: Format und Text Änderungen
    Keine Änderung in der Logik
2024-04-18 Umstrukturierung (KEIN Code geändert)
    [bt_test arduino nano + hc05.sch]
2024-04-18 Eagle Fernsteuerung
    [Fernsteuerung.brd, Fernsteuerung.sch]
2024-04-19 board fersteuerung
    [Fernsteuerung.brd, Fernsteuerung.sch]
2024-04-19 Fernsteuerung Plaine fertig
    [Fernsteuerung.brd, Fernsteuerung.sch]
2024-04-20 Fernsteuerung Board fertig
    [Fernsteuerung.brd]
2024-04-20 Umgebung und Bildschirm zusammengefügt mit dem Rest des Codes
2024-04-22 Platine
    platine auf github
    [DRILEGEND.CFG, rc_car.brd, rc_car.sch]
2024-04-22 unnötig
    [Bluetooth Test Arduino nano + HC05.sch, DRILEGEND.CFG, Fahrzeug.brd, Fahrzeug.sch]
2024-05-19 lidar sensor auf bildschirm
2024-05-20 Display info + Routenfindung + Bluetooth connect fix + better UX & features
    [Bluetooth.cpp, Fernsteuerung.ino, LeeAlgorithm.cpp, LeeAlgorithm.h, LidarMapper.cpp, LidarMapper.h, TFTDisplay.cpp, TFTDisplay.h]
2024-05-21 fix 15 12 meter + fix wrong values
    [Fernsteuerung.ino]
2024-05-21 Bluetooth fix + Neuer Modus "Automatisch" + verbesserter Modus "Volle Umdrehung"
    [Bluetooth.cpp, Fernsteuerung.ino, LidarMapper.cpp]
2026-10-29 Rewrite README and add project documentation
    - New English README: problem, solution, architecture, engineering
    decisions, features, hardware, Bluetooth protocol, build steps, team
    - Add docs/ with demo GIF, photos, schematic, final presentation PDF
    and October 2023 project pitch
